JanDerogee/TeleJukebox/photo/Total_setup.JPG

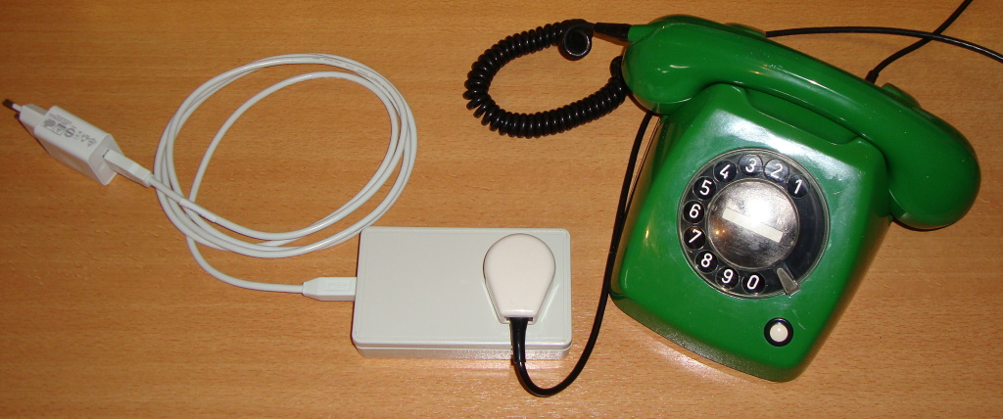
photo/Total_setup.JPG
