JanDerogee/TeleJukebox/schematic_and_PCB/PCB_v1.04.jpg

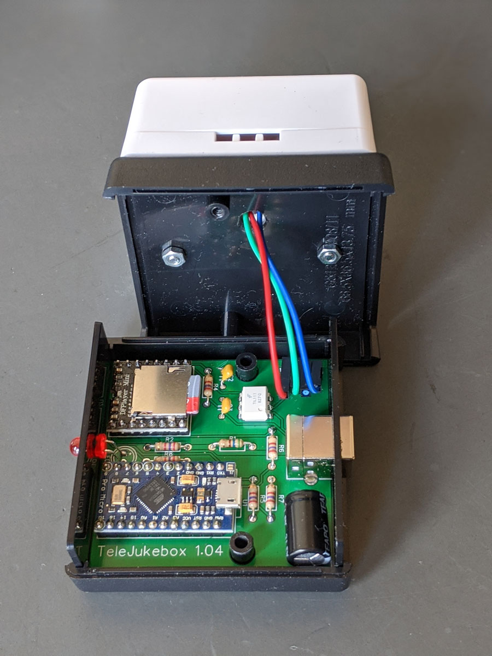
schematic_and_PCB/PCB_v1.04.jpg
