JanDerogee/TeleJukebox/schematic_and_PCB/readme.txt

The PCB was drawn by Paul Hulsebosch in EasyEDA.
There are 2 schematic files available: Schematic_TeleJukebox_V1.03.png, TeleJukebox.jpg
Both are electrically identical however some may find the .jpg version easier to read, therefore both version are available.
