JanDerogee/TeleJukebox/photo/case_open_closeup.JPG

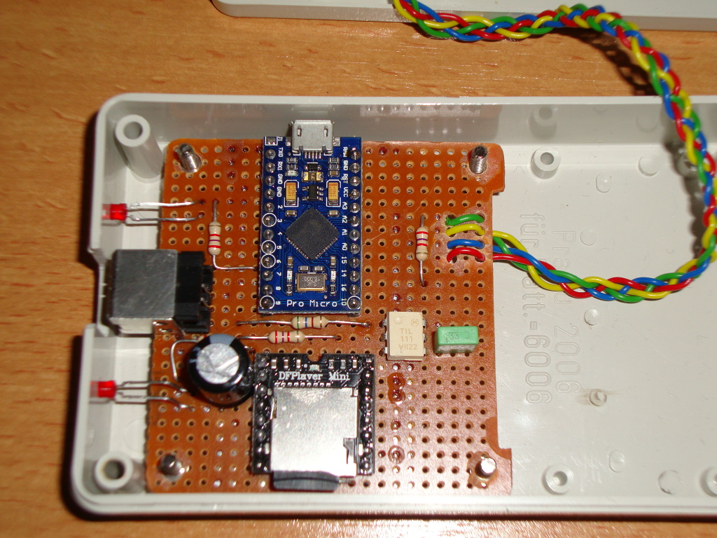
photo/case_open_closeup.JPG
