JanDerogee/TeleJukebox/photo/case_open_top.JPG

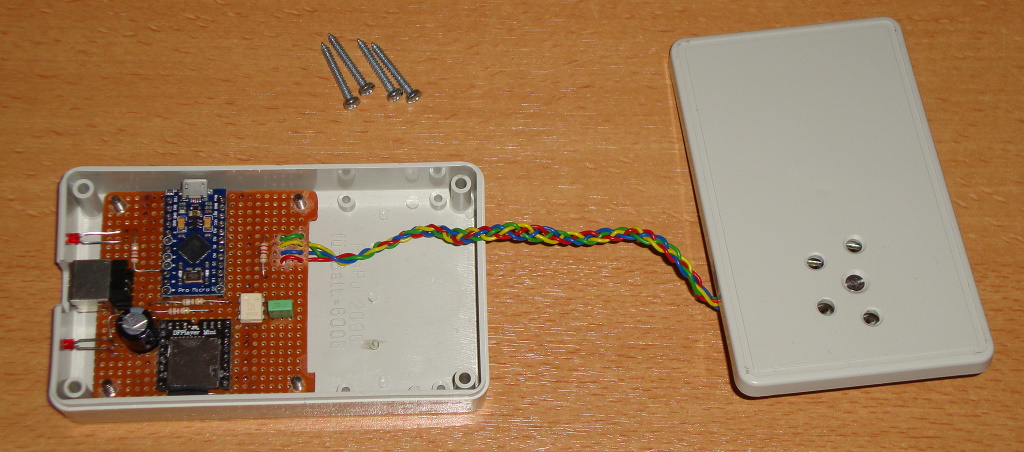
photo/case_open_top.JPG
