JanDerogee/TeleJukebox/photo/case_open_top_inside.JPG

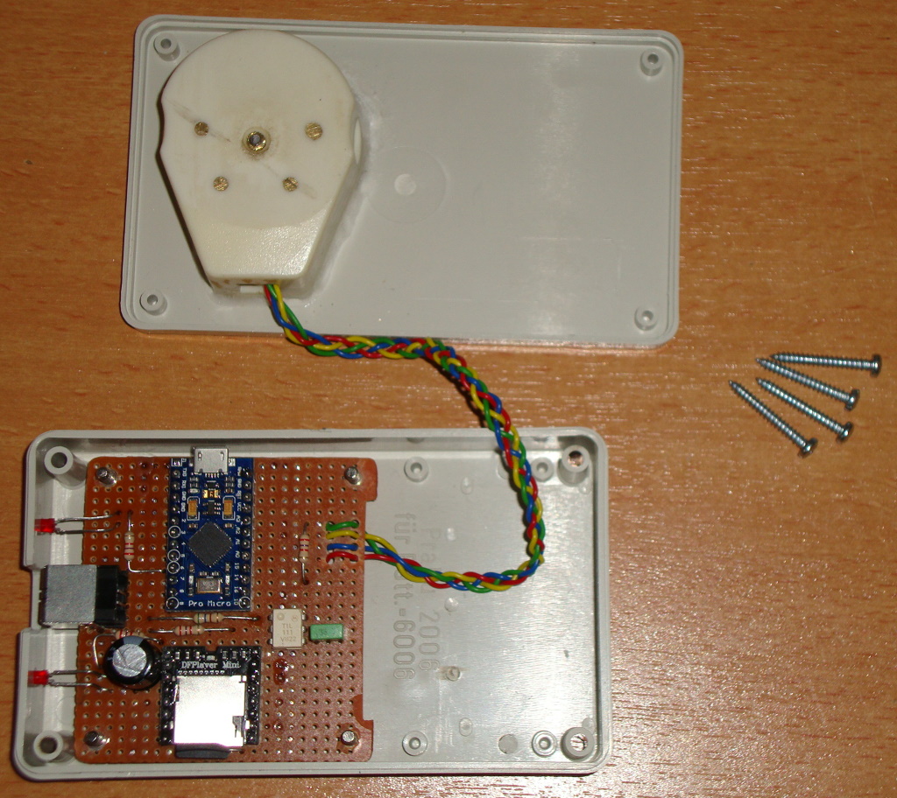
photo/case_open_top_inside.JPG
