JanDerogee/TeleJukebox/photo/connections_inside_phone.JPG

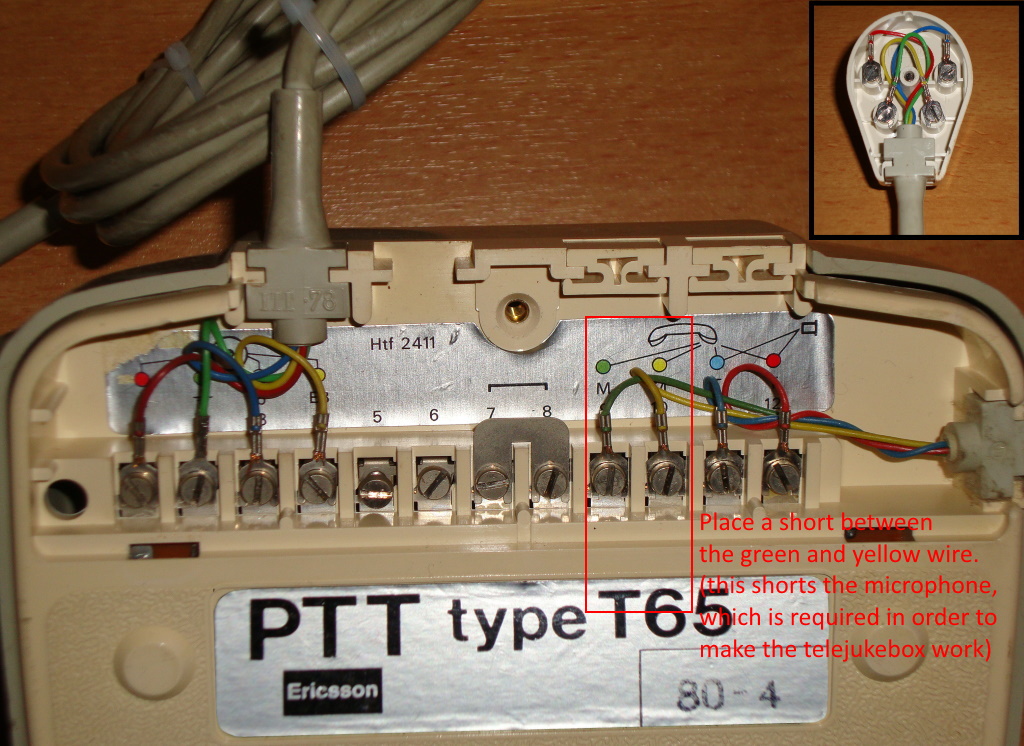
photo/connections_inside_phone.JPG
