JanDerogee/TeleJukebox/schematic_and_PCB/Schematic_TeleJukebox_V1.03.png

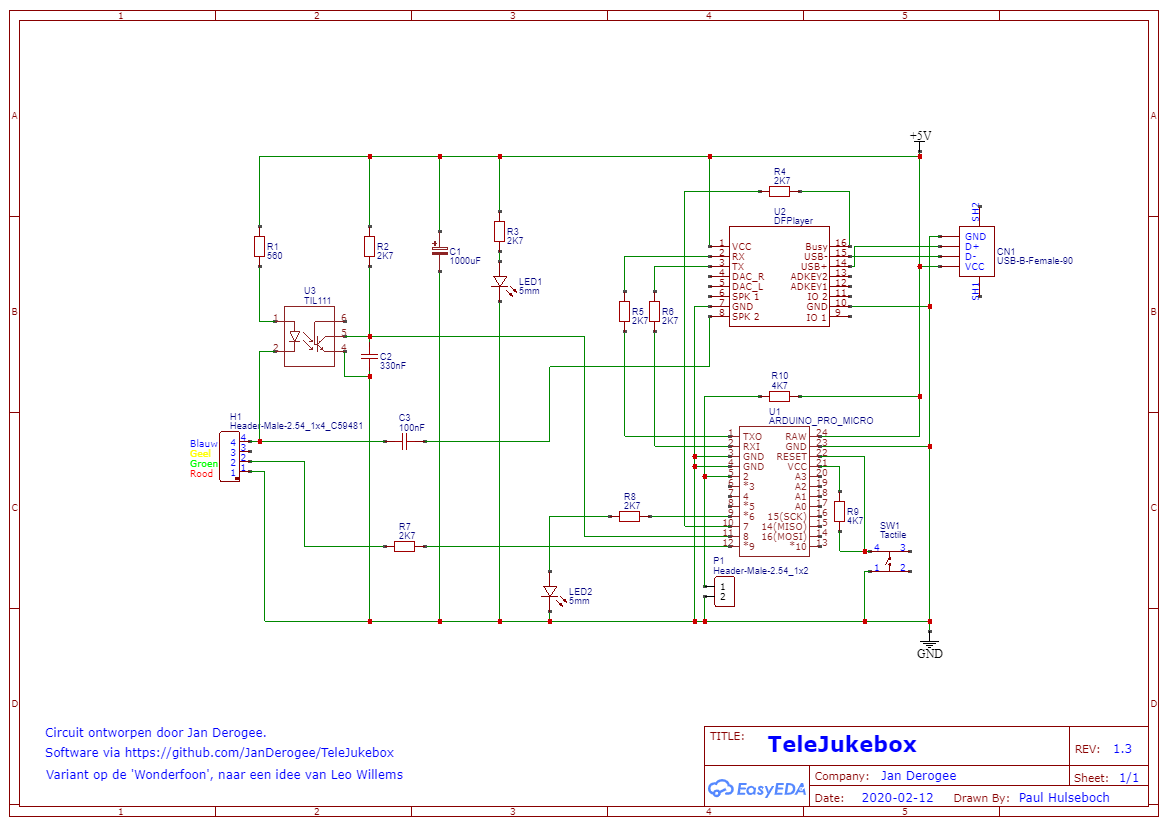
schematic_and_PCB/Schematic_TeleJukebox_V1.03.png
