JanDerogee/TeleJukebox/schematic_and_PCB/TeleJukebox.jpg

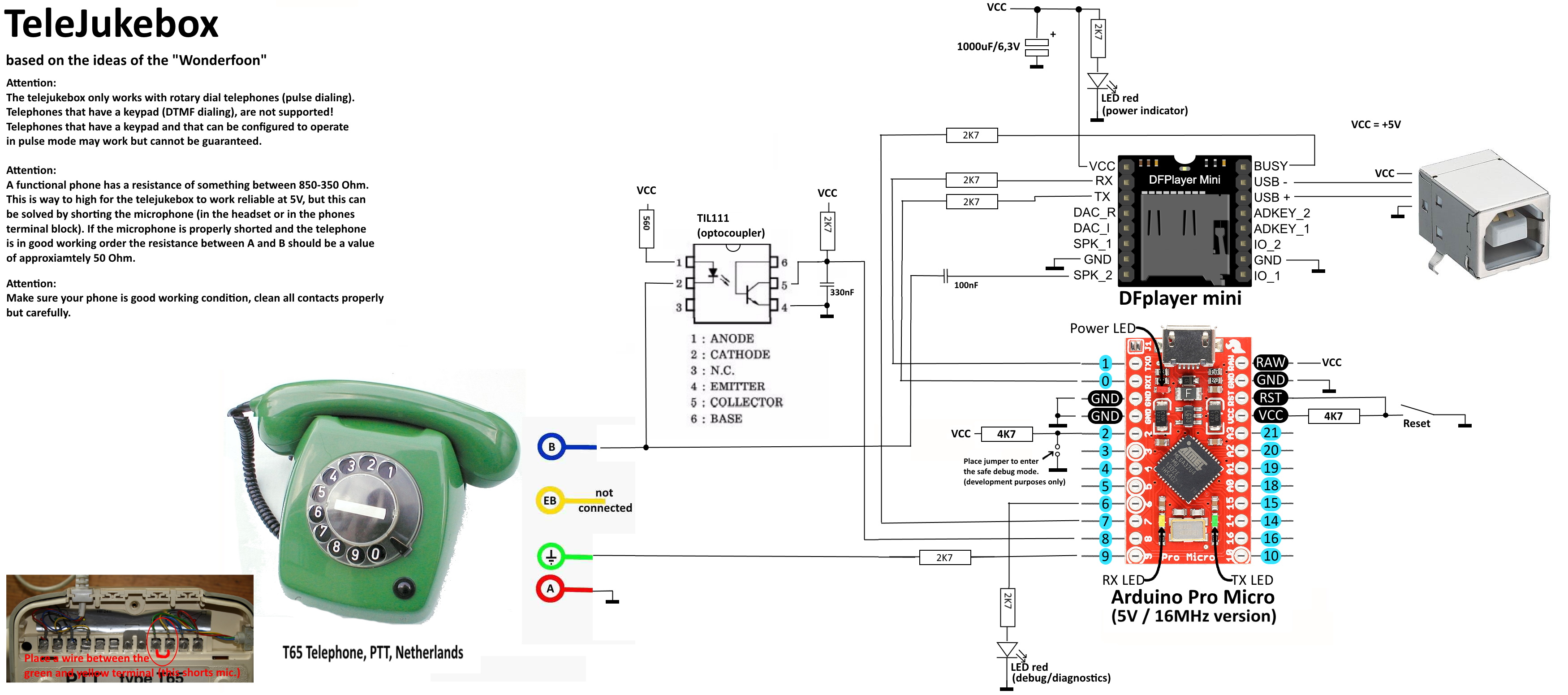
schematic_and_PCB/TeleJukebox.jpg
