JanDerogee/TeleJukebox/KostenTeleJukebox.xls

Kosten TeleJukebox | Stukprijs | Aantal | Totaal
Pcb | €0.50 | 1 | €0.50
Arduino Pro Micro (https://www.vanallesenmeer.nl/Arduino-Pro-Micro-ATmega32U4-5V-16MHz-compatibel) | €6.30 | 1 | €6.30
DFPlayer (https://www.aliexpress.com/item/4000379417594.html) | €0.75 | 1 | €0.75
TIL111 (https://www.reichelt.nl/optocoupler-til-111-p21365.html) | €0.41 | 1 | €0.41
Weerstand 4K7 Ohm (https://www.conrad.nl/p/yageo-cfr-25jt-52-4k7-koolfilmweerstand-47-k-axiaal-bedraad-0207-025-w-5-1-stuks-1417695) | €0.08 | 2 | €0.16
Weerstand 2K7 Ohm (https://www.conrad.nl/p/yageo-cfr-25jt-52-12k7-koolfilmweerstand-27-k-axiaal-bedraad-0207-025-w-5-1-stuks-1417646) | €0.08 | 7 | €0.56
Weerstand 560 Ohm (https://www.conrad.nl/p/yageo-cfr-25jt-52-560r-koolfilmweerstand-560-axiaal-bedraad-0207-025-w-5-1-stuks-1417655) | €0.08 | 1 | €0.08
Elco 1000 µF 6.3 V (https://www.reichelt.nl/elko-1000-f-6-3-v-105-c-rad-lxz-6-3-1k0-p166328.html) | €0.13 | 1 | €0.13
Condensator 330nF (https://www.conrad.nl/p/tancap-ct4-0805y334m500a1t-keramische-condensator-tht-330-nf-50-v-20-b-x-h-42-mm-x-25-mm-1-stuks-1578738) | €0.13 | 1 | €0.13
Condensator 100nF (https://www.conrad.nl/p/tancap-ct4-0805y104m500c1t-keramische-condensator-tht-100-nf-50-v-20-b-x-h-42-mm-x-25-mm-1-stuks-1584724) | €0.05 | 1 | €0.05
Led (https://elektronica-online.nl/product/voordelige-5mm-rode-led-5030) | €0.03 | 2 | €0.06
USB, type B, pcb (https://www.reichelt.nl/usb-inbouwkoppeling-type-b-gebogen-pcb-lum-2411-02-p116160.html) | €0.64 | 1 | €0.64
Tactile switch (https://www.digikey.nl/product-detail/en/te-connectivity-alcoswitch/1825910-6/450-1650-ND/1632536) | €0.09 | 1 | €0.09
Pinheader, male (https://www.reichelt.nl/rnd-pin-header-7-polig-rm-2-54-mm-rnd-205-00628-p208854.html?trstct=pos_7&nbc=1) | €0.03 | 1 | €0.03
Jumper kabel (https://www.hobbyelectronica.nl/product/dupont-malefemale-breadboard-jumper-kabels-20cm/) | €0.09 | 4 | €0.36
Micro sd-kaart (https://www.aliexpress.com/item/33043840927.html?spm=a2g0s.9042311.0.0.27424c4dUzjfMZ) | €2.47 | 1 | €2.47
PTT wandcontactdoos (https://www.gamma.nl/assortiment/q-link-telefoon-contactdoos-opbouw-modulair-4-polig-wit/p/B547149) | €2.99 | 1 | €2.99
Behuizing (https://www.reichelt.nl/kunststof-behuizing-66-5-x-66-5-x-28-mm-rnd-455-00879-p238812.html) | €1.22 | 1 | €1.22
Totaal |  |  | €16.93
