JanDerogee/TeleJukebox/manual/Gebruiksaanwijzing_TeleJukebox.rtf

Gebruiksaanwijzing TeleJukebox

INHOUD
1. Gebruiksaanwijzing
1.2 Aansluiten
1.3 Bediening
1.4 Instellingen
2. Muziek wijzigen
3. Achtergrond

1. Gebruiksaanwijzing

1.2 Aansluiten
Om de TeleJukebox te kunnen gebruiken heb je nodig:
- De TeleJukebox (een klein kastje met daarop een wit stopcontact waarop een oude draaischijftelefoon aangesloten kan worden).
- Een oude draaischijftelefoon, zoals de T65 van de PTT.
- De oplader van een mobiele telefoon.
- Een kabel om de lader op de TeleJukebox aan te sluiten.

Volgorde:
- Sluit de draaischijftelefoon aan op de TeleJukebox.
- Sluit de kabel aan op de TeleJukebox.
- Sluit het andere einde van de stroomkabel aan op de oplader van de mobiele telefoon.
- Steek de oplader in een stopcontact.

De TeleJukebox zal nu opstarten. Dat duurt ongeveer 10 seconden. Neem na die 10 seconden de hoorn op. Je hoort een welkomstboodschap waarin verteld wordt dat de TeleJukebox in werking getreden is en welke instellingen gekozen zijn. Luister die boodschap af en leg de hoorn op de haak. Daarna is de TeleJukebox klaar voor gebruik en kan hij muziek afspelen. De welkomstboodschap klinkt elke keer dat de TeleJukebox uit het stopcontact gehaald is en opnieuw is aangesloten.

1.3 Bediening
1.3.1 Normaal gebruik
De TeleJukebox kan 10 muziekjes afspelen. De bediening is heel simpel: als je de hoorn opneemt en tegen je oor houdt, hoor je een kiestoon. Draai je vervolgens een cijfer, dan hoor je het corresponderende muziekje. Als de muziek is afgelopen, klinkt opnieuw de kiestoon. Dan kan er een nieuw cijfer gedraaid worden, om een nieuw muziekje te starten. Wil je niet het hele muziekje afluisteren, dan kun je tussentijds de hoorn op het toestel terugleggen, opnieuw opnemen en een ander cijfer draaien.
1.3.2 Willekeurige volgorde
De TeleJukebox heeft ook een optie om de 10 nummers in willekeurige volgorde achter elkaar af te spelen. Op de meeste draaischijftelefoons vind je rechts onder de draaischijf een drukknop. Neem de hoorn op, wacht op de kiestoon en druk vervolgens op de knop. Er start dan een willekeurig nummer. Als dat afgelopen is, start een van de 9 andere nummers. Op die manier kan iemand langere tijd doorlopend muziek luisteren. Om luisteren in willekeurige volgorde af te sluiten, hoef je enkel de hoorn op de telefoon te leggen. Niet elk toestel heeft een dergelijke drukknop. Heb je een toestel zonder een dergelijke knop, dan is het helaas niet mogelijk om muziek in willekeurige volgorde achter elkaar af te spelen.

1.3.3 Noodnummers
Als iemand de TeleJukebox gebruikt om noodnummers als 112, 911 of 0908844 te draaien, klinkt er een gesproken boodschap die duidelijk maakt dat deze telefoon niet geschikt is voor het gebruik van dergelijke noodnummers en dat daarvoor een ander toestel gebruikt moet worden.

1.3.4 Grapjes / easter eggs
Er waren vroeger meer drie- of viercijferige telefoonnummers voor speciale gelegenheden. Denk aan nummers als 002, 003 en 008, voor het opvragen van tijd, weer en een telefoonnummer. Deze en sommige andere nummers kunnen ook met de TeleJukebox gedraaid worden. Probeer ze eens uit.

Let wel: de drie- en viercijferige nummers dienen snel achter elkaar gedraaid te worden (binnen 10 seconden). Als er meer tijd zit tussen het draaien van de cijfers, gebeurt er niets.

1.4 Instellingen
1.4.1 Keuzemenu
De TeleJukebox heeft drie instellingen die aangepast kunnen worden via de draaischijf van de telefoon:
- Volume (10 - 100%)
- Muziekmap (1 - 10)
- Easter eggs (aan - uit)

Om de instellingen aan te passen is er een speciaal instellingsmenu. Er zijn twee manieren om in het instellingsmenu te komen. Op de meeste draaischijftelefoons is rechts onder de draaischijf een ronde knop te vinden. Houdt die knop ingedrukt terwijl je de hoorn opneemt. Wacht een seconde en laat de knop los. Je hoort een boodschap die je welkom heet in het instellingsmenu. Luister naar de opties, maar kies pas een van de opties als de stem je daartoe opdracht geeft. Alles wat je voor die tijd draait, wordt genegeerd.

Als je een telefoon hebt zonder de druktoets rechts onder de draaischijf, kun je het instellingsmenu bereiken door de hoorn op te nemen en snel achter elkaar de cijfers 7, 3 en 8 te draaien. Draai de drie cijfers met niet meer dan 5 seconden pauze na elk cijfer.

1.4.2 Volume (standaard = 100%)
Het is waarschijnlijk het best om het volume op 100% ingesteld te laten staan doordat oudere personen vaak niet optimaal meer horen. Mocht het volume van de muziek toch te hard zijn, kan het op een lager percentage ingesteld worden. Het ingestelde volume heeft alleen betrekking op de muziek. Het volume van de gesproken tekst in het menu is altijd 100%.
1.4.3 Muziekfolder (standaard = 1)
De TeleJukebox kan een selectie van tien muzieknummers afspelen. Maar het geheugen van de TeleJukebox biedt ruimte aan tien mappen met ieder tien muzieknummers. Daartussen kan via het instellingsmenu gewisseld worden. Dat biedt de mogelijkheid om mapjes muziek aan te leggen voor verschillende gelegenheden, zoals een map met kerstliedjes en een map met Sinterklaasliedjes.

1.4.4 Easter egg menu (standaard = aan)
De easter egg modus is een grapje van de programmeur van de TeleJukebox. Je kunt grappige boodschappen horen door bepaalde drie- of viercijferige telefoonnummers te draaien. Als dat onwenselijk is, kan de optie uitgezet worden.

2. Muziek wijzigen

2.1 Voorbereiding
De TeleJukebox bevat een micro-sd-kaart waarop de muziek geplaatst is. Je kunt de inhoud van de sd-kaart wijzigen door de TeleJukebox op een computer aan te sluiten. Haal het snoer van de TeleJukebux uit de meegeleverde voeding en sluit het snoer vervolgens aan op een pc. De TeleJukebox wordt dan door de pc herkend als usb-stick.

2.2 Micro-sd-kaart
De TeleJukebox kan enkel mp3-bestanden afspelen die op de ingebouwde micro-sd-kaart opgeslagen zijn. De muziek hoort opgeslagen te zijn in de volgende mappen op de micro-sd-kaart: 01, 02, 03, 04, 05, 06, 07, 08, 09 en 10.

Map 90 bevat de audio-bestanden van het menu (de kiestoon en de teksten die te horen zijn in het menu). Map 99 bevat de audio-bestanden van de easter eggs.

Als je nieuwe muziekbestanden aan de TeleJukebox toe wilt voegen, moeten die op een specifieke manier opgeslagen worden. De TeleJukebox kijkt naar de naam van de bestanden, maar herkent van die naam enkel de eerste drie tekens. Die tekens dienen bovendien cijfers te zijn die de volgorde binnen de map aangeven. Een muziekbestand hoort dus een naam te hebben als 000.mp3 of 001.mp3. Tot maximaal 009.mp3. De muziekbestanden mogen echter een langere naam hebben dan 000,mp3. Dus voor de herkenbaarheid mag een nummer ook '001-Dorus - Er zitten twee motten.mp3' heten.
Voor de mappen 01 tot en met 10 geldt:
000-<naam van lied>.mp3 = dit is het lied dat klinkt als een 0 gedraaid wordt
001-<naam van lied>.mp3 = dit is het lied dat klinkt als een 1 gedraaid wordt
002-<naam van lied>.mp3 = dit is het lied dat klinkt als een 2 gedraaid wordt
003-<naam van lied>.mp3 = dit is het lied dat klinkt als een 3 gedraaid wordt
004-<naam van lied>.mp3 = dit is het lied dat klinkt als een 4 gedraaid wordt
005-<naam van lied>.mp3 = dit is het lied dat klinkt als een 5 gedraaid wordt
006-<naam van lied>.mp3 = dit is het lied dat klinkt als een 6 gedraaid wordt
007-<naam van lied>.mp3 = dit is het lied dat klinkt als een 7 gedraaid wordt
008-<naam van lied>.mp3 = dit is het lied dat klinkt als een 8 gedraaid wordt
009-<naam van lied>.mp3 = dit is het lied dat klinkt als een 9 gedraaid wordt

Als je de gewenste muziek op de micro-sd-kaart hebt opgeslagen, zorg er dan voor dat je de TeleJukebox op een veilige manier loskoppelt van de pc. Daarna kan de TeleJukebox weer aangesloten worden op de meegeleverde voeding.

3. Achtergrond - TeleJukebox en Wonderfoon

De TeleJukebox is een variant op de Wonderfoon. Voor zowel de Wonderfoon als de TeleJukebox geldt: het is een oude draaischijf-telefoon die is omgebouwd tot muziekspeler. Aan elk van de tien cijfers op de draaischijf is een muziekje toegewezen. Neem je de hoorn op en draai je een cijfer, dan hoor je het bijbehorende muziekje. Leg je neer, neem je opnieuw op en draai je een ander cijfer, hoor je een ander muziekje.

De Wonderfoon is een idee van Leo Willems. Hij maakte het eerste exemplaar voor zijn dementerende schoonmoeder. Het sloeg direct aan. Mensen met dementie kennen de oude telefoons met draaischijf nog en als de telefoon gevuld is met muziek uit hun jeugd, veren ze doorgaans helemaal op. De Wonderfoon is gebaseerd op de T65, de grijze draaischijftelefoon die de PTT in 1965 introduceerde en die jarenlang het enige toestel was dat in Nederland voor handen was.

Willems heeft een bouwinstructie vrijgegeven, zodat ook anderen een T65 tot Wonderfoon kunnen ombouwen. Voor de methode die Willems volgt, moet de telefoon echter opengemaakt worden en de inwendige elektronica eruit gesloopt, om zo ruimte te maken voor de muziekspeler. Dat is natuurlijk zonde van die mooie, oude telefoon. Daarop bedacht Jan Derogee dat het ook anders kon. Hij verzon het concept voor de TeleJukebox, een extern kastje dat hetzelfde kan als de Wonderfoon. Op de TeleJukebox kun je een T65 aansluiten, zonder dat die gesloopt hoeft te worden. De T65 kan daarmee in zijn originele staat dienst doen als Wonderfoon. Al kan het doorgaans geen kwaad om zowel de binnenkant als de buitenkant van het toestel eerst grondig te reinigen.

De TeleJukebox heeft stroom nodig om te kunnen werken. Die stroom kan geleverd worden door een willekeurige oplader van een mobiele telefoon. Een geschikte lader wordt meegeleverd.
