JanDerogee/TeleJukebox/(threads)

Thread 1 (2019-12-02):

Schematic TIL111 pin 4

reijndert, 2019-12-02:
In the schematic pin 4 of the TIL111 is not connected. I assume pin 4 is connected to ground?

JanDerogee, 2019-12-03:
Hello Reijndert,
you are completely correct, the broken line should be continuos, I'll fix it.
Thanks for letting me know.

Kind regards,
Jan

________________________________
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

Closed 2020-08-09.

Thread 2 (2019-12-03):

Arduino Nano

fgeer, 2019-12-03:
Hello Jan,

Can I use Arduino Nano instead of the Pro Micro?
Can I play more then 10 numbers?

JanDerogee, 2019-12-03:
I only used a Pro Micro because I personally prefer that model. The design does not have special functions that require the Pro Micro. Though, the benefit of the Pro Micro is it's USB connector, allowing the entire project to be powered through a simple USB poweradapter. So convenient for development and easy to build as you do not need to worry about power connectors, just use your phone charger.

So to make a long story short, I haven't tried it on a Nano, but it should work.

Can it play more then 10 numbers, well, technically it can IF you modify the code. The number of numbers you can play is technically limitted by the MP3 player and the SD-card. So you could make it to play hundreds of different songs. But it requires you to modify the code to allow for the entry of multiple digits. The only reason it can now play 10 songs, is because it plays the song related to the dialed digit, once dialed, playback begins.

fgeer, 2019-12-03:
Ok thanks but Nano also have a usb conn. and is cheaper!

Closed 2020-08-09.

Thread 4 (2020-08-05):

PCB 1.04 but no schematic 1.04

beamzer, 2020-08-05:
Hi, I got a PCB version 1.04 which i was soldering, but it seems that this version is not completely compatible with the 1.03 schematic? In 1.03 i see some resistors which are not the on the PCB. Can you help out?

TIA,
Ewald...

JanDerogee, 2020-08-05:
Hello Ewald,
I didn't make the PCB myself, somebody else made it, so I don't have access to the schematic files.
Hoewever the differences are very small. The 1.04 version doesn't have an power LED, it doesn't have a reset button and it doesn't have a jumper.
The jumper was intended for debugging purposes, but the code doesn't need this jumper to run.
The reset button was intended for debugging purposes, but the code doesn't need this jumper to run.
The power LED was for fun, but you don't really need it. The other LED which is connected to an IO-pin is much more usefull. So to save space the LED thta only indicated power was removed from the board to save space and power.

I hope this info is helpfull,
kind regards,
Jan

________________________________
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

beamzer, 2020-08-10:
I checked with Paul who designed the v1.04 and he said that the resistor values are just the same as v1.03 and R8, R9 and R10 are left out on purpose.

Closed 2020-08-09.

Thread 5 (2021-02-22):

TeleJukbox maken

bartgubbels11, 2021-02-22:
Hallo Jan,

Het is mij gelukt om de T65 met draaischijf werkend te krijgen (:

Ik ben nu bezig om een T65 TDK om te zetten naar en Telejukbox. Het verschil is dus dat de T65 TDK werkt met toon (DTMF) in plaats van pulse. Als ik een draaischijf op de t65 TDK zet werkt de telejukbox wel. Ik zou echter graag willen dat de T65 TDK met toetsen ook werkt.

Is er misschien een manier om de toon om te zetten naar een pulse signaal of is dat niet mogelijk.
Of zou ik de file van arduino kunnen aanpassen waardoor dit wel zou kunnen werken. Ik heb zelf niet heel veel verstand van arduino dus misschien dat u dat wel Kan/weet?

Ik hoor het wel!

Met vriendelijke groet,

Bart

JanDerogee, 2021-02-22:
Hallo Bart,
goed om te horen dat je de telejukebox heb gebouwd en dat het lijkt te werken.
Met zo'n oude telefoon kan er immers een hoop mis zijn.

De telejukebox ondersteund geen DTMF oftewel geen toonkiezen.
Het vergt flinke aanpassingen in de firmware (arduino code) EN in de hardware!

Het probleem zit 'm in de toon, dit is een analoog signaal, oftewel audio. In het geval van de draaischijf is het een puur digitaal signaal. Er is wel of er is geen puls, dat is bijzonder eenvoudig detecteerbaar en dus veel gemakkelijker te programmeren dan continue luisteren of er een toon is. Omdat de charme van de telejukebox voor een groot deel in de draaischijf zit EN in het intact laten van de telefoon. Heb ik dan ook geen enkele moeite gestoken in het ondersteunen van DTMF. En dus heb ik de hardware zo eenvoudig mogelijk gemaakt zodanig dat deze eigenlijk alleen werkt voor pulskiezen. Ik heb verder ook geen ambities om DTMF te ondersteunen. Op het moment dat ik dat zou doen ben ik bijna een telefoon centrale aan het bouwen en dat ging me wat te ver.

Ik hoop dat dit een beetje duidelijk is, maar in de basis is DTMF vele malen complexer dan pulskiezen.

Met vriendelijke groet
Jan Derogee.

________________________________
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

bartgubbels11, 2021-02-23:
Hallo Jan,

Heel erg bedankt voor de snelle reactie!

Dus als ik het goed begrijp is daar eigenlijk geen beginnen aan. Ik zie dat je een puls signaal met een converter over kan zetten naar toon kiezen (DTMF). Is het dan niet op een of andere manier mogelijk om dat andersom te krijgen door bijvoorbeeld een converter of iets dergelijks toepast .

Ik hoor het wel

Met vriendelijke groet,

Bart Gubbels

JanDerogee, 2021-02-24:
Hallo bart,
Het klinkt logisch om een toon signaal om te zetten naar een puls signaal m.b.v. een losse converter schakeling. Echter ik heb hier geen ervaring mee. Het is ook niet een veelvoorkomend probleem, immers het is een stap terug in techniek, het levert geen snelheidswinst op en er is geen goede reden waarom er een dergelijke schakeling al zou bestaan. Iets dat gewoon te koop is bedoel ik dan. Maar aan de andere kant, ik heb het wel vaker mis...
Om een lang verhaal kort te maken, ik weet het niet. Maar mocht je toch zo'n converter weten te vinden dan Jan ik geen garantie geven dat het ook werkt met de telejukebox. Er is immers een grote kans dat de telefoon aan 5volt niet genoeg heeft en geen tonen wil genereren. Maar ook dat weet ik niet.

Kortom, ik Jan je hier niet echt verder mee helpen.
Groeten, Jan.

Outlook voor Android downloaden<https://aka.ms/ghei36>

________________________________
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

JanDerogee, 2021-02-26:
case closed

Closed 2021-02-26.

Thread 6 (2021-04-12):

Error bij instelling menu

bartgubbels11, 2021-04-12:
Hallo Jan,

Ik heb een probleem dat zodra ik naar de instellingen toe ga en dan een keuze maak tussen geluid, muziek map, easter egg functie dat het geluid dan hapert/ vasthangt(stuk overslaat). Ik heb de arduino, mp3 speler, sd kaart en de octocoupler vervangen Hier lag het probleem echter niet.

Heeft u een idee hoe dit komt?

Ik hoor het wel!

Groetjes,

Bart

JanDerogee, 2021-04-12:
Dit klinkt als een vaag probleem. Mijn eerste hok zou de SD kaart zijn. Verwijder alle bestanden, formatteer de kaart en kopieer alles in de juiste mappen zoals het hoort.
Maar het kan ook een ordinair contact probleem zijn in de telefoon zelf. Controleer alle contacten? Ik ga er verder vanuit dat de telefoon op de juiste manier is aangesloten en de microfoon is kortgesloten.
Verder is het voor mij lastig om een exacte diagnose te stellen, in de code is zo gauw geen aanleiding te vinden voor dit probleem, dus ik verwacht toch dat het ergens in de hardware zit
Het kan ook een voedingsproblemen zijn, dus probeer het eens met een andere 5v voeding, dat lijkt me een snelle test. Let op... Het kan natuurlijk ook aan de voedingskabel liggen, dus test dat ook.

Succes.

Outlook voor Android<https://aka.ms/AAb9ysg> downloaden

________________________________
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

bartgubbels11, 2021-04-14:
Hallo Jan,

Ik heb al 1 andere Telejukbox gemaakt waar dit probleem niet voorkomt. Ik gebruik daarvoor precies dezelfde draaitelefoon/adapter. Vaak is het zo dat als ik naar de instellingen wil gaan dat er eerst wordt gezegd deze instelling is niet mogelijk en dan gaat het goed totdat je een keuze maakt. De uitleg van wat je moet doen wordt dan af en toe overgeslagen of dat het hapert.

Ik denk dat het dan toch te maken heeft met het solderen. Het enigste wat vreemd is dat alleen in het instelling menu een fout optreed.

bartgubbels11, 2021-04-14:
Hallo Jan,

Is het trouwens ook de bedoeling om de usb type b vast te solderen?

JanDerogee, 2021-04-14:
Hallo Bart,
wat bedoel je precies met vast solderen?
Waarom zou je deze NIET vast solderen dan? Uiteraard moet elk component op de hiervoor bedoelde manier worden vastgesoldeerd.

Maar als je misschien bedoel je of je ook de USB aansluiting op de arduino kunt gebruiken om het geheel te voeden dan is het antwoord, nee! Gebruik de usb type b.
Deze "lompe" connetcor is niet alleen vele malen steviger het garandeert ook dat alle spanningen op de juiste manier bij alle onderdelen aankomen.  Op het arduino bord zit namelijk een diode die wat van de spanning afsnoept hierdoor krijgt de MP3 speler een spanning lager dan 5V en kunnen er nare dippen ontstaan ten tijde van piekverbruik. Nu is dit alles ook afhankelijk van de gebruike voeding en het type van de geplaatste diode op het arduino bordje... een Chinese kloon kan een diode hebben met een hogere interne weerstand en hogere drempel spanning. Het punt is dat je weet dit niet tot je er tegenaan loopt. Die dingen zijn zo goedkoop om een reden.
Als je de schakeling voedt via de grote lompe usb b connector dan heb je al deze potentiele problemen niet EN het geeft je de mogelijkheid de MP3 speler als USB stick te benaderen.

Groeten
Jan D.

________________________________
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

JanDerogee, 2021-04-14:
Hier is iets geks aan de hand, controleer alle spanningen en soldeercontacten.
Ik heb eerder de indruk dat de MP3 speler niet goed functioneert de verklaring hiervoor ligt meestal in de SD kaart (opnieuw formateren en files in de juiste folders met de juiste bestandsnamen aan de kaart toevoegen) of aan een voedingsprobleem. Controleer daarom alle voedinsgpunten, dan kan eigenlijk alleen met een oscilloscope, een multimeter is niet snel genoeg om kritische spanningsdippen weer te geven. Maar met gezond verstand en een multimeter kun je wel een heel eind komen. Als de 5V aan de ingang op andere plekken geen 5V meer is dan is er iets aan de hand. Zorg er in ieder gavlk voor dat begint met een degelijke 5V voeding en een fatsoenlijke kabel (de langste en goedkoopste USB kabel van de action of aliexpress hebben vaak te dunne draadjes en hierdoor een te hoge weerstand. Een kort dik snoer is dus beter dan een lange dunne.
Controleer ook of de puslen van de kiesschijf degelijk zijn een denderend of krakend contact kan er voor zorgen dat de telejukebox schakeling een ander getal ziet dan je zou verwachten. Het helpt hierbij om de schakeling aan de arduino omgeving te koppelen en terminal functie te gebruiken, dan zie je wat debug informatie over het scherm van je computer rollen die je verder kan helpen om dit probleem op te lossen. Verder is het voor mij bijzonder lastig om dit probleem zo over email op te lossen.

Succes,
Jan D.

________________________________
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

bartgubbels11, 2021-04-26:
Hallo Jan,

Dank voor u hulp!
Ik heb het probleem denk ik gevonden. Ik heb 2 verschillende soorten DFPlayer gekocht. De een doet het helemaal goed en andere doet het wel maar op sommige momenten niet. (Zie afbeelding)

Met vriendelijke groet,

Bart Gubbels
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

JanDerogee, 2021-04-26:
oh... dat is vreemd... maar ook erg interessant!
Dit maakt mij erg nieuwsgierig naar de andere zijde van de PCB, kunt u daar misschien een zelfde soort foto van maken?

Groeten
Jan D.

________________________________
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

bartgubbels11, 2021-04-26:
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

Hier ziet u de andere zijde van de pcb .
Groeten,
Bart Gubbels

JanDerogee, 2021-04-26:
Dankuwel voor deze waardevolle info

Outlook voor Android<https://aka.ms/AAb9ysg> downloaden

________________________________
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

bartgubbels11, 2021-04-26:
Ik denk ook niet dat u gelijk weet waarom de ene wel goed werkt en de andere niet?

JanDerogee, 2021-04-26:
Ik heb geen flauw idee, maar er is zo te zien een duidelijk verschil. Het zou me niets verbazen als er dus ook andere gebruikseigenschappen zijn. Maar ik vraag me nu wel af welke versie ik dan gebruik, dus dat ga ik vanavond eens uitzoeken.

Outlook voor Android<https://aka.ms/AAb9ysg> downloaden

________________________________
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

JanDerogee, 2021-04-26:
Hallo Bart,
op basis van de voor mij beschikbare informatie kan ik geen verdere conclusies trekken over de oorzaak van dit probleem.
Op zich zou je verwachten dat 2 modules die onder dezelfde naam verkocht worden een gelijkwaardig gedrag vertonen. Echter als de ene het soms niet doet dan is er op de een of andere manier iets mis mee.
Dit kan te maken hebben met signaal niveaus, in serie met de RX en TX lijn staan weerstanden (R5 en R6) van 2k7 verder zijn alle andere lijnen hard aangesloten. Het zou misschien zou kunnen zijn dat deze weerstanden iets kleiner moeten zijn in het uiterste geval mogen ze 0 Ohm zijn. Echter de functie van deze weerstanden is het terugdringen van een hinderlijke "ruis". Nu kan het zo zijn dat dit voor de module met problemen minder speelt, dus dat is een experimentje waard. Sluit de weerstanden eens voor de test eens kort met een draadje om te zien of dit het probleem verhelpt. Het beste zou natuurlijk zijn om met een oscilloscoop de signaal niveaus the verifieren maar dit werkt ook (we moeten wel praktisch blijven nietwaar).

Zo verder zou ik het ook niet weten, de informatie over deze modules is bijzonder schaars.
Succes en laat met even weten wat de resultaten zijn van deze kleine test.
Jan D.

________________________________
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

bartgubbels11, 2021-05-03:
Hallo Jan,

Ik heb de weerstanden R5 en R6 kortgesloten. Er veranderde niet veel. Verder heb ik de weerstanden vervangen door een weerstand van een paar ohm alleen dit baat ook niet. Je hoort dan inderdaad ook een hinderlijke ruis als je de weerstanden verlaagd. Ik ga hier nog verder mee experimenteren dus als ik nieuwe informatie hierover heb dan laat ik u dat weten.

Met vriendelijke groet,

Bart G

JanDerogee, 2021-05-03:
Hoi Bart, bedankt voor de info. Succes, dit is een vervelend probleem. Erg naar dat deze module lijkt op degene die we nodig hebben maar zich toch net iets anders gedraagt. Misschien dat het een voedingsprobleem is. Je zou eens kunnen experimenteren met iets van 1000uf extra over de 5v. Het is het proberen waard.

Outlook voor Android<https://aka.ms/AAb9ysg> downloaden

________________________________
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
