JanDerogee/TeleJukebox/schematic_and_PCB/Schematic_TeleJukebox_V1.03.pdf

# GNDSH¹ SH²

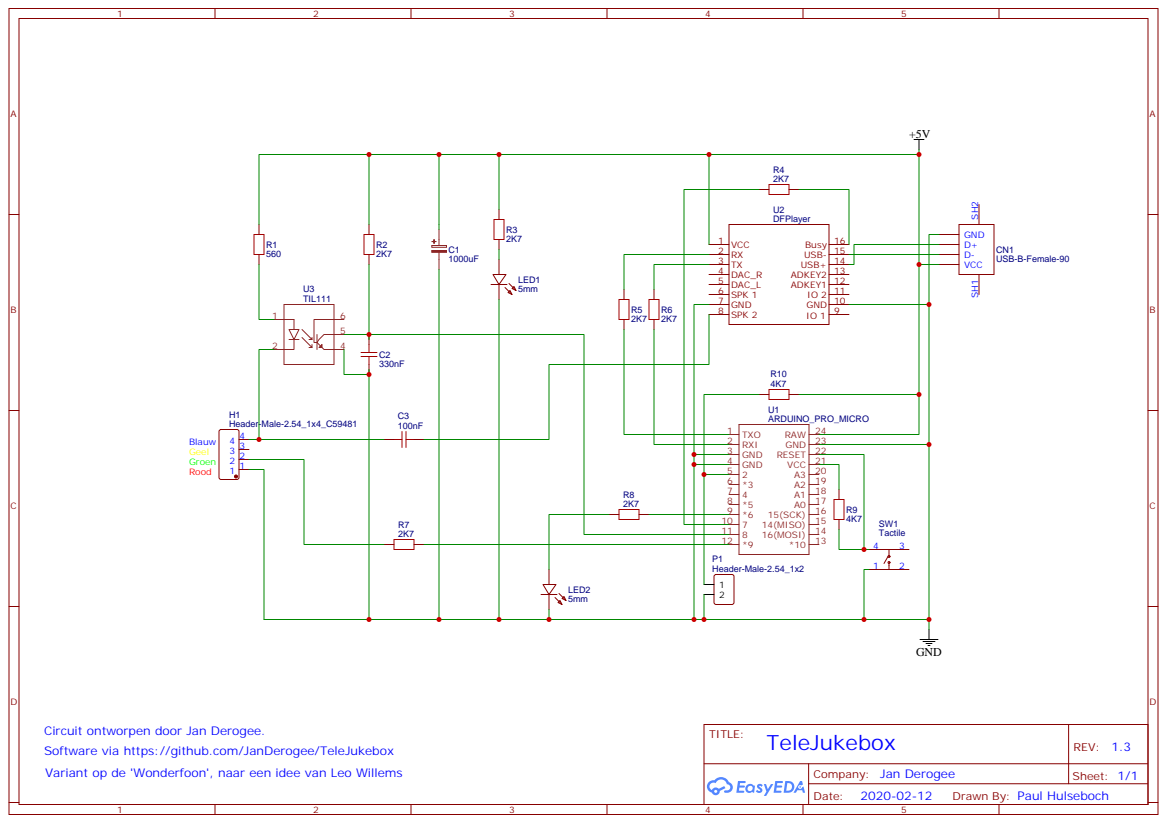
[picture p24: page 1]

GND 10 IO 2 11 ADKEY1 12 ADKEY2 13 USB+ 14 USB- 15 Busy 16

Circuit ontworpen door Jan Derogee.
Software via https://github.com/JanDerogee/TeleJukebox
Variant op de 'Wonderfoon', naar een idee van Leo Willems

Drawn By: Paul Hulseboch
