JanDerogee/TeleJukebox/(commit log)

2019-12-03 Schematic correction and louder MP3s
    Schematic missed a part of the line between TIL111 pin 4 and ground. This has now been corrected.
2020-02-06 info about USB driver
    modified readme with info about driver for the Arduino "Pro Micro" module from Sparkfun
    added a photo with the wiring connections of a supported phone
2020-02-06 Update README.md
    corrected some end-of-line nonsense that screwed up the layout...
2020-02-12 improved hardware
    The hardware has been improved and is now more reliable. It does require the phone's microphone to be shorted. This reduces the entire phones impedance to approx 50 Ohm. Allowing for a more reliable dial-pulse detection and a much louder volume from the phones speaker.
    Also some easter eggs have been added, dial 002, 003, 008.
    The firmware also has been changed to add this new functionality. And the pulse detection is no longer done digitally (which relies on the thresshold of the IO-pin) but analog, so we can determine our own trigger level and create a very large hysteresis swing to be less susceptable to noise.
    [TeleJukebox.ino]
2020-02-12 phone terminal block
    To make the telejukebox project work, a short needs to be placed between the green and yellow wire. This shorts out the microphone and reduces the impedance of the phone to a reliably low and practical level.
2020-02-23 added english laguage speech files and related emergency number support
    Since everything in this project is documented in english, english speech files should be available too.
    Also as a fan of "The IT crowd" i could not resists adding the emergency number 0118 999 881 999 119 725 3 to the list of possible emergency numbers. I know it's useless, consider it an easter egg that does nothing special. For those who are not familiar with this number, this may be of help: https://www.youtube.com/watch?v=ab8GtuPdrUQ
2020-02-23 PCB and schematic in new folder
    pcb was in zipped version, is now unzipped for easy access
2020-02-24 minor spelling change in manual, added MP3 file
    There was a minor spelling error in the manual SD-cad, should be SD-card.
    There was an MP3 file missing, therefore the number 10, could not br pronounced.
2020-03-06 Partslist (in dutch)
    This is a partslist describing the costs (in Dutch and made using LibreOffice Calc) of the TeleJukebox.
    It contains a list of parts required for assembly of the TeleJukebox and their individual costs. This list was created by one of the builders (not me) but can be of use to others and is therefore hosted here. This list will expire (as prices vary and links will die) and will not be actively supported.
    [KostenTeleJukebox.xls]
2020-04-04 Added new PCB layout, Gerber v1.04
    This layout no longer has the power-led, reset-switch and debug pinheader. These functions were mostly for development purposes. Now these components are removed from the PCB design, thr PCB is a little bit smaller and fits more easily in it's case.
2020-04-04 added image of PCB v1.04 inside a box
    Added image of PCB v1.04 inside a box.
    PCB layout and assembly all done by Paul Hulsebosch.
2021-02-26 Add files via upload
    additional information about programming Sparkfun Pro Micro board, this document was written by a Telejukebox user
